tyama501/ps2busmouse98/(commit log)

2021-05-25 Add the acknowledge checking and error handling to enable data reporting
    [ps2busmouse98.ino]
2021-05-29 Moved watch dog error message
    [ps2busmouse98.ino]
2021-06-09 Add the parity checking and error handling
    [ps2busmouse98.ino]
